rithvikpillai/robert_me588/Electrical Schematic.pdf

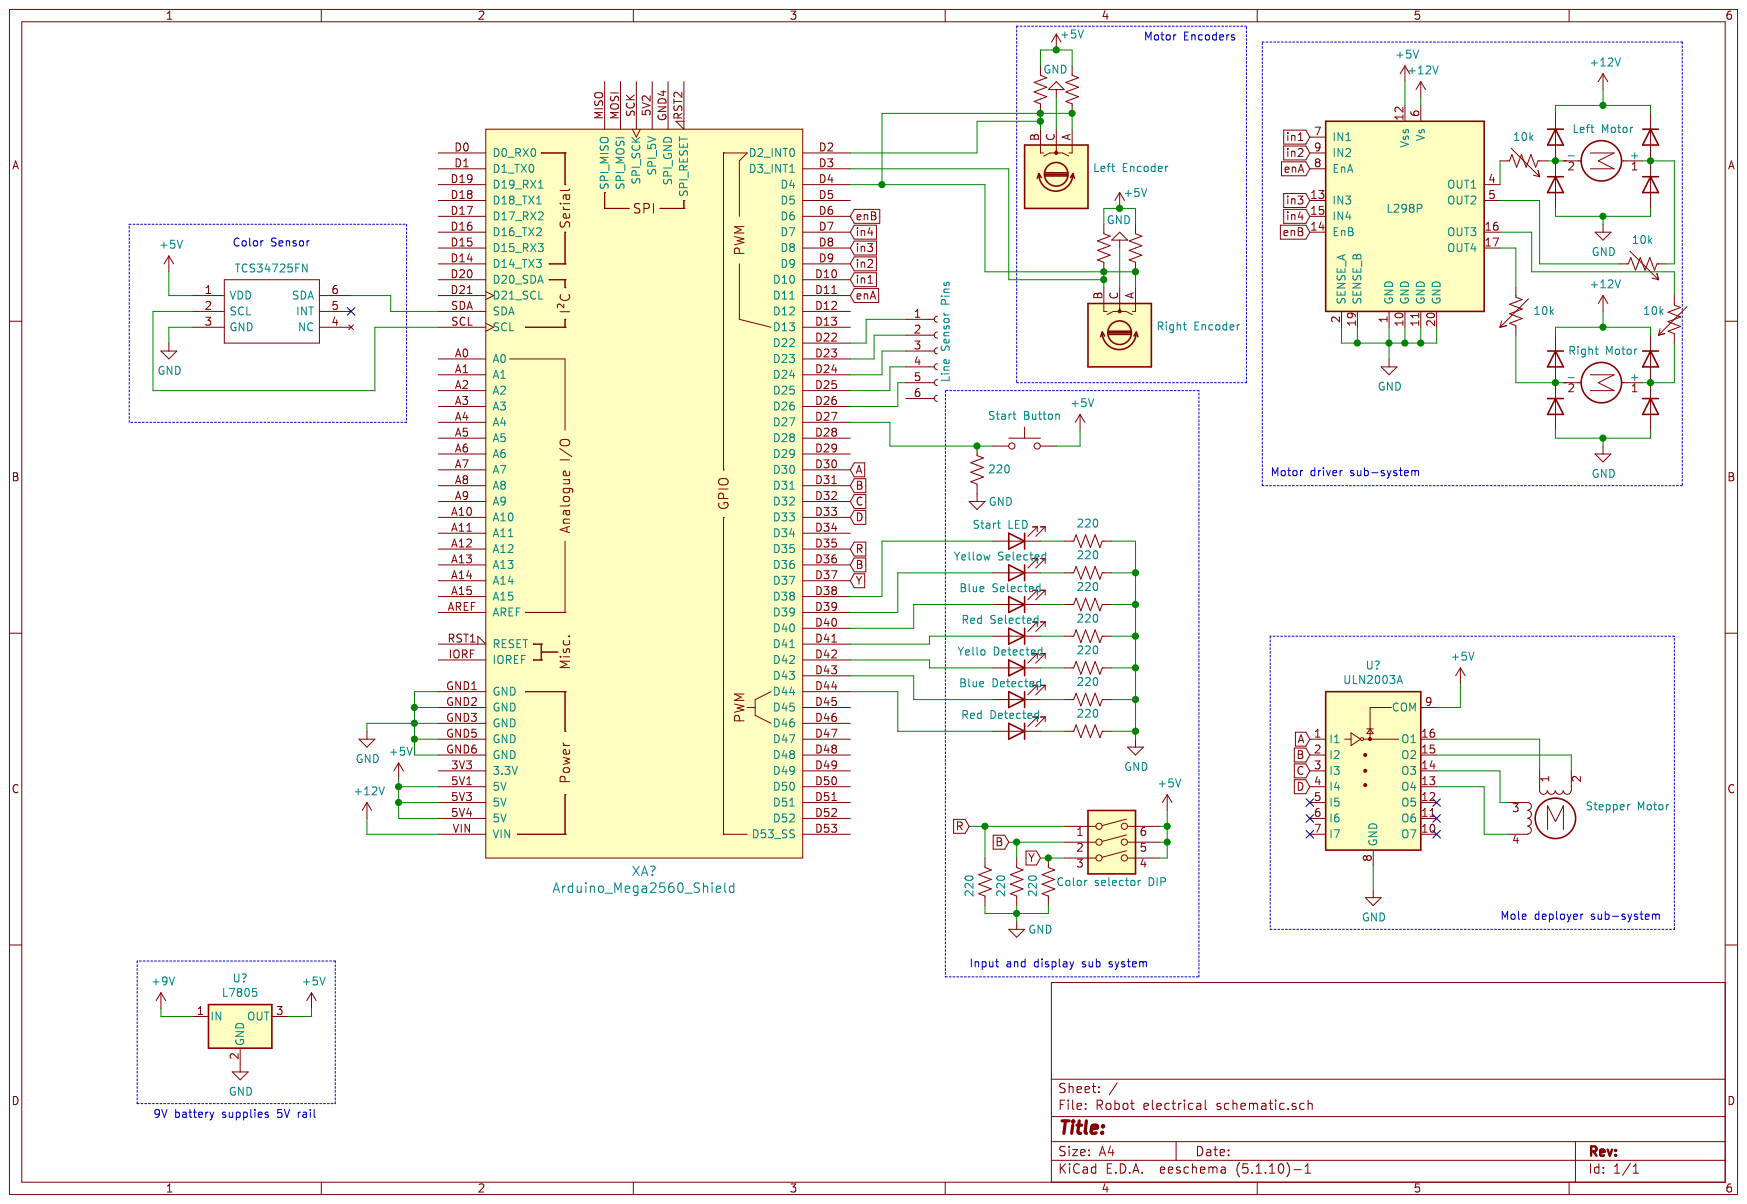
[picture p20: page 1]
